Ji-Xuan-Huang/Open-Source-MIDI-Platform/04.KNOBs/Main.pdf

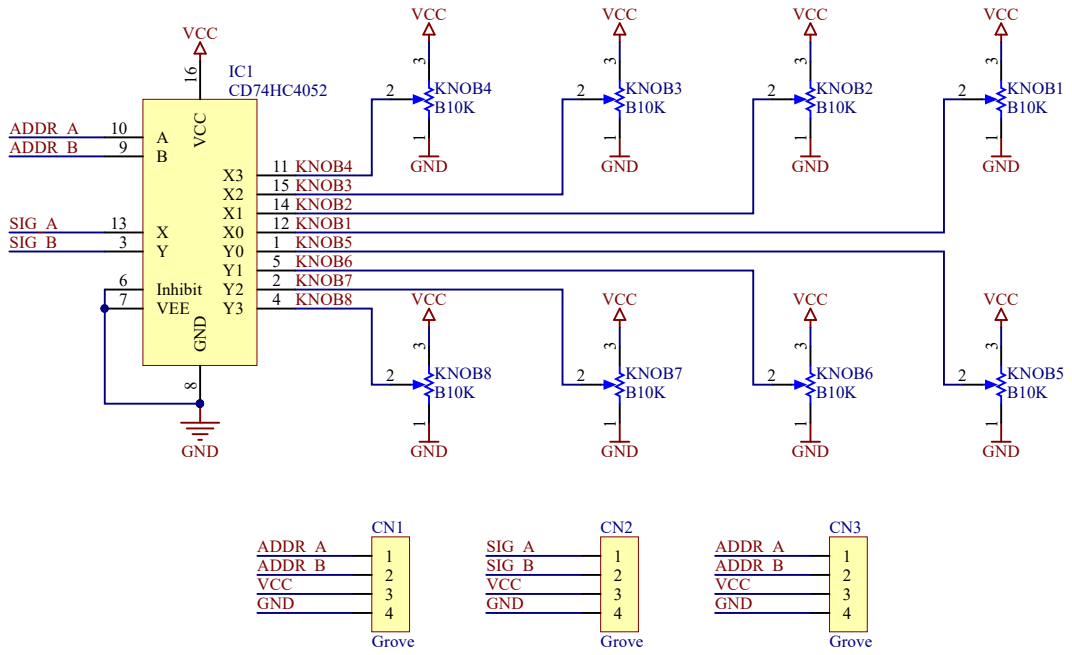
[picture p36: page 1]

5 | KN OB6
2 | KN OB7
