Ji-Xuan-Huang/Open-Source-MIDI-Platform/03.PADs/Main.pdf

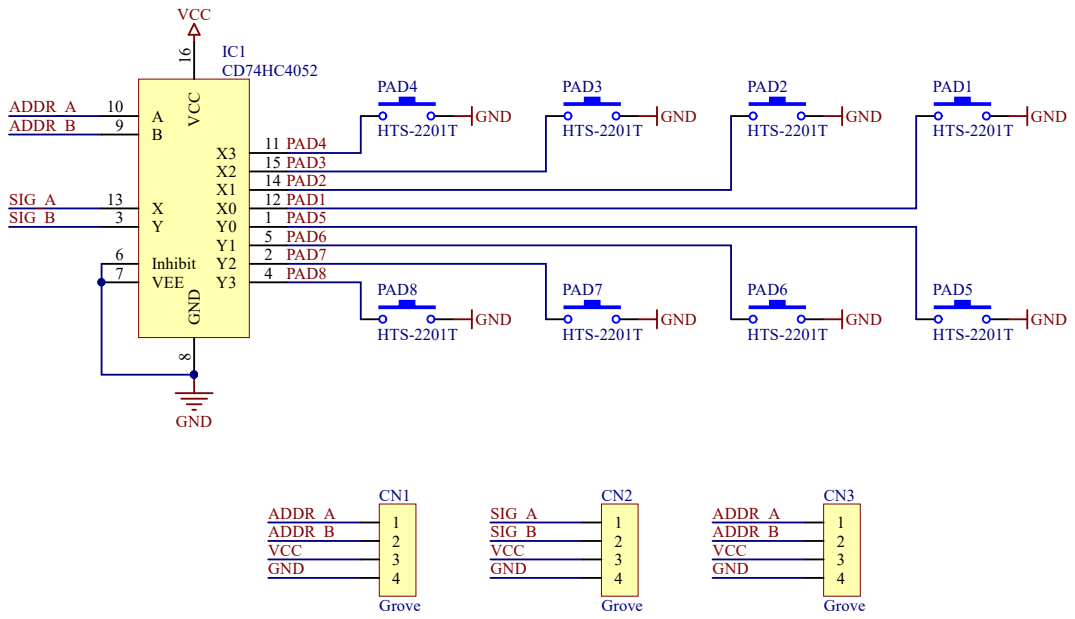
[picture p37: page 1]
