Ji-Xuan-Huang/Open-Source-MIDI-Platform/02.KEYs/Main.pdf

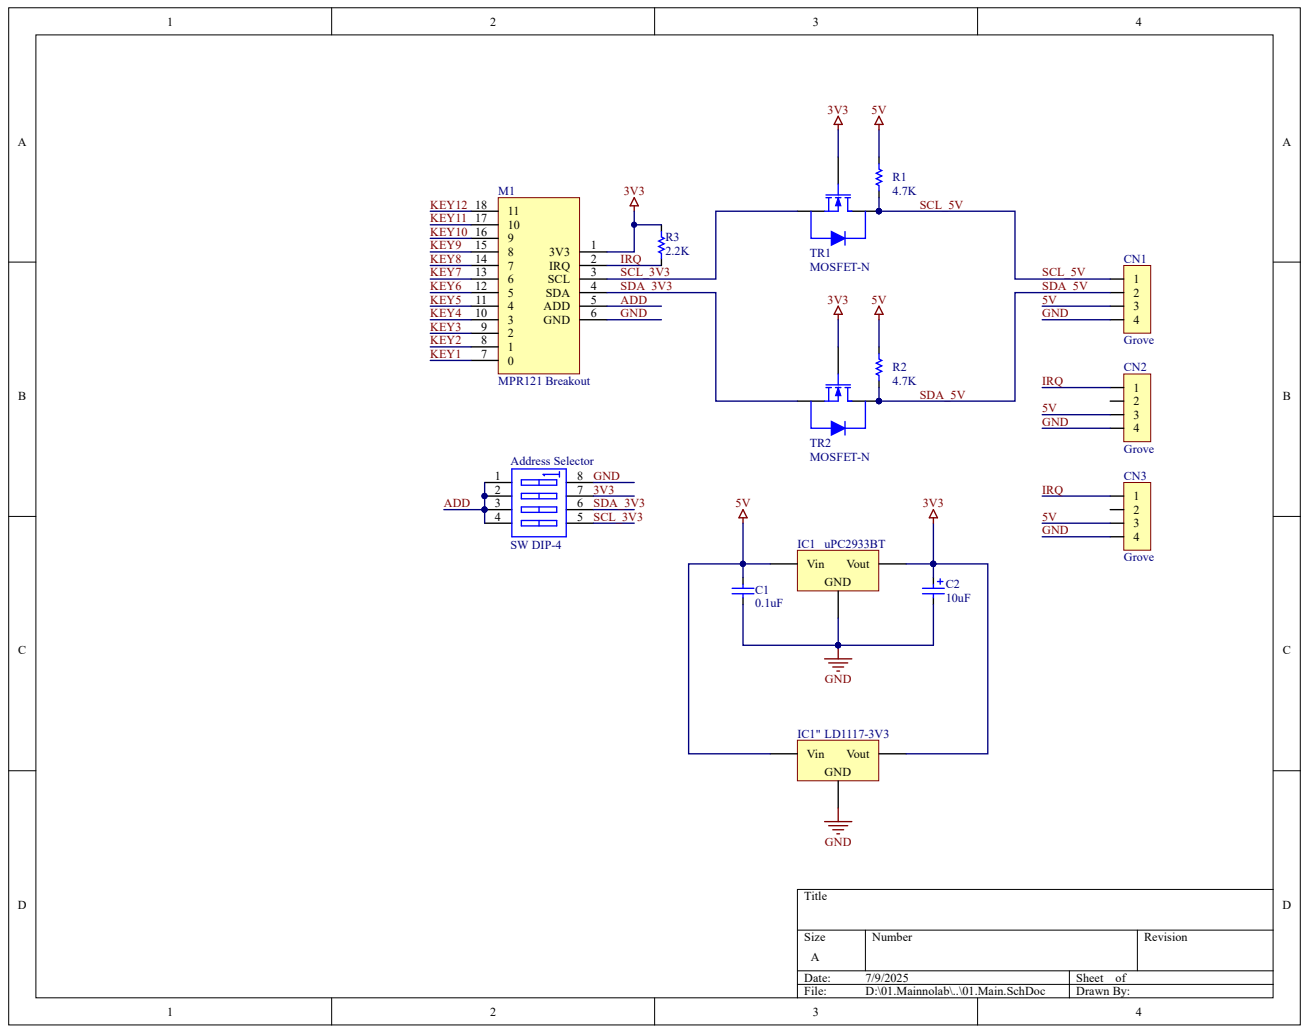
[picture p38: page 1]
