Ji-Xuan-Huang/Open-Source-MIDI-Platform/01.MainBoard/Main.pdf

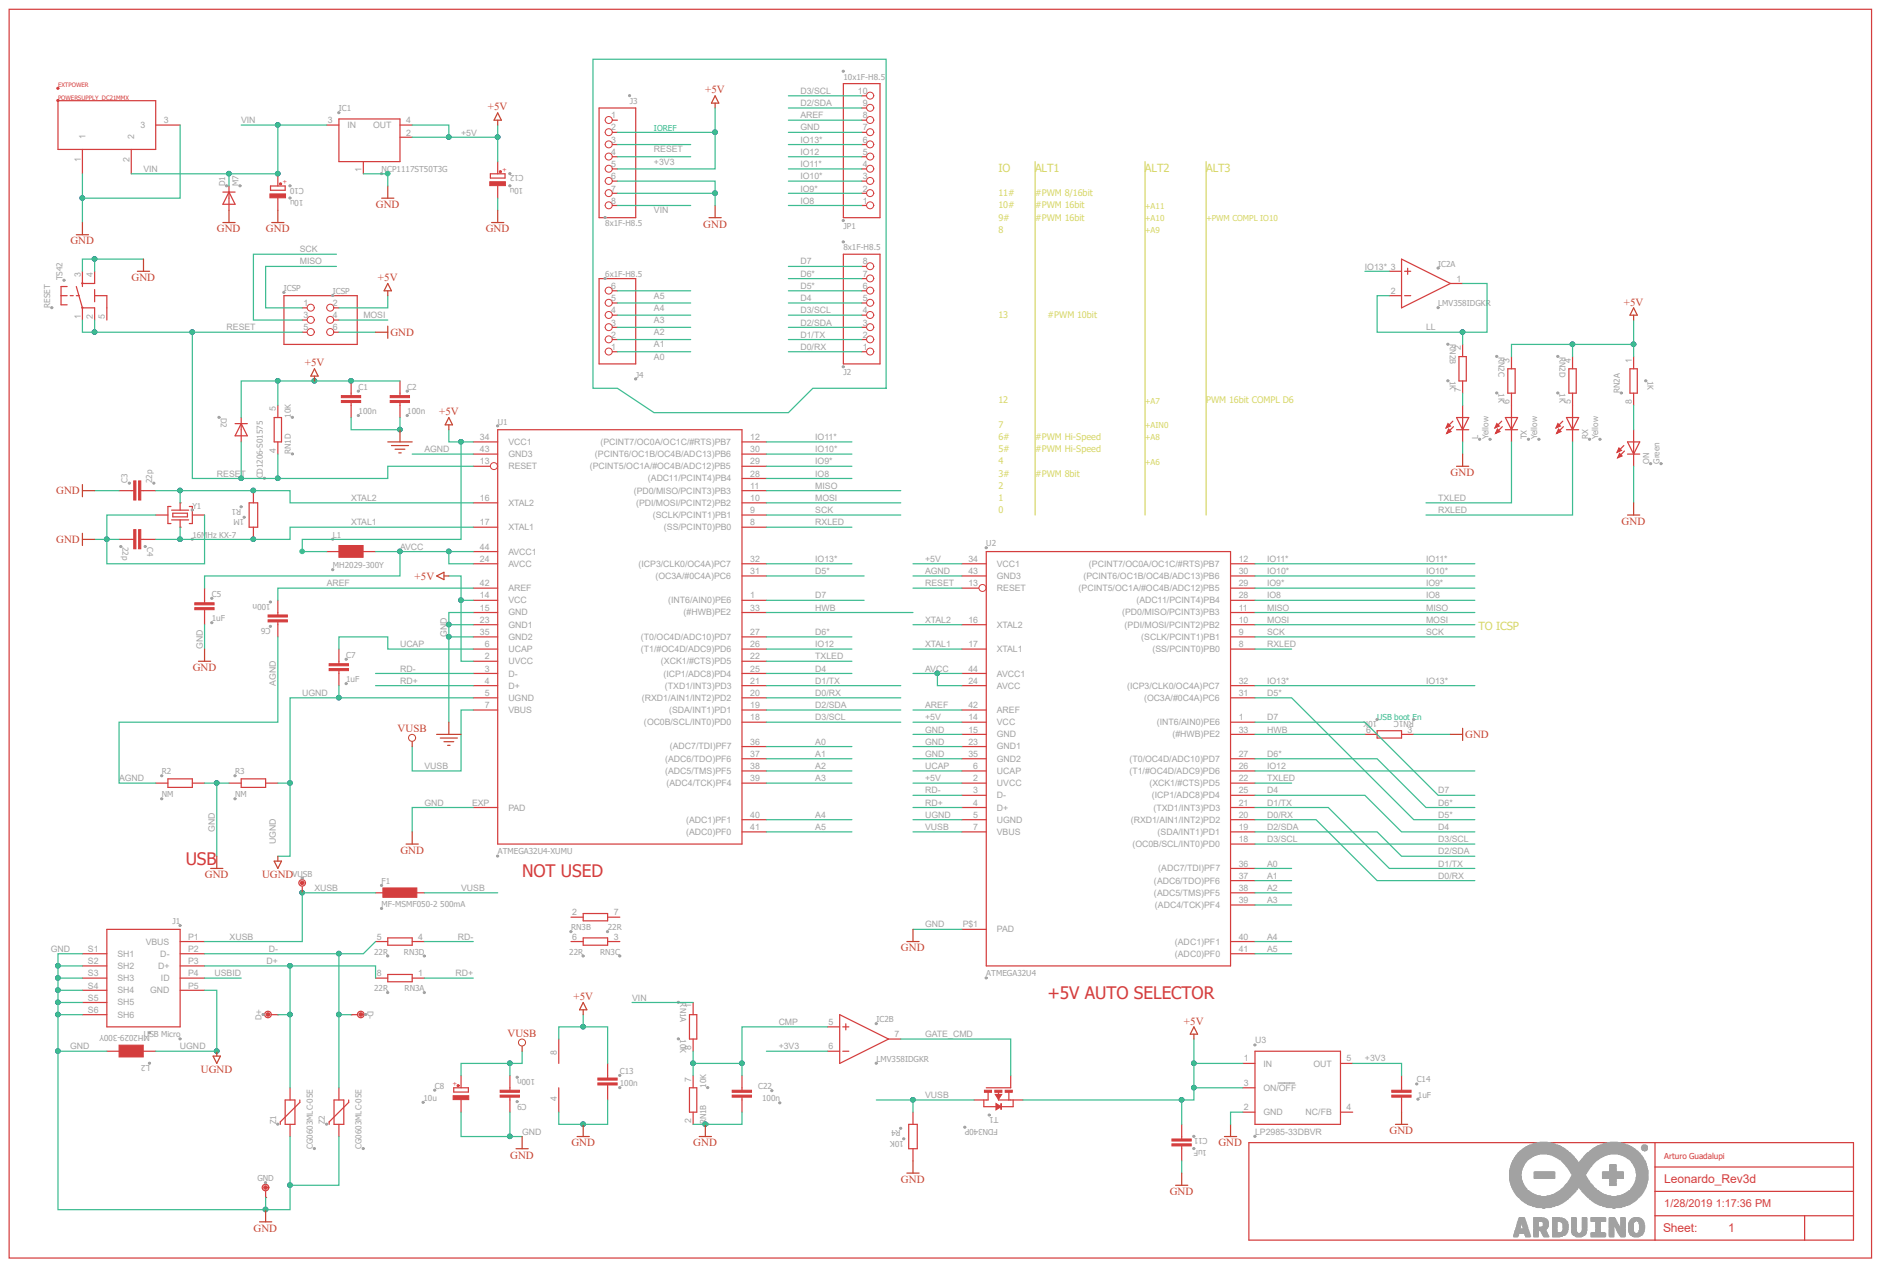
[picture p39: page 1]

AVCC

S 2 | | P D+
S 3 | | P4 5 ID US BID
S 4 | | P

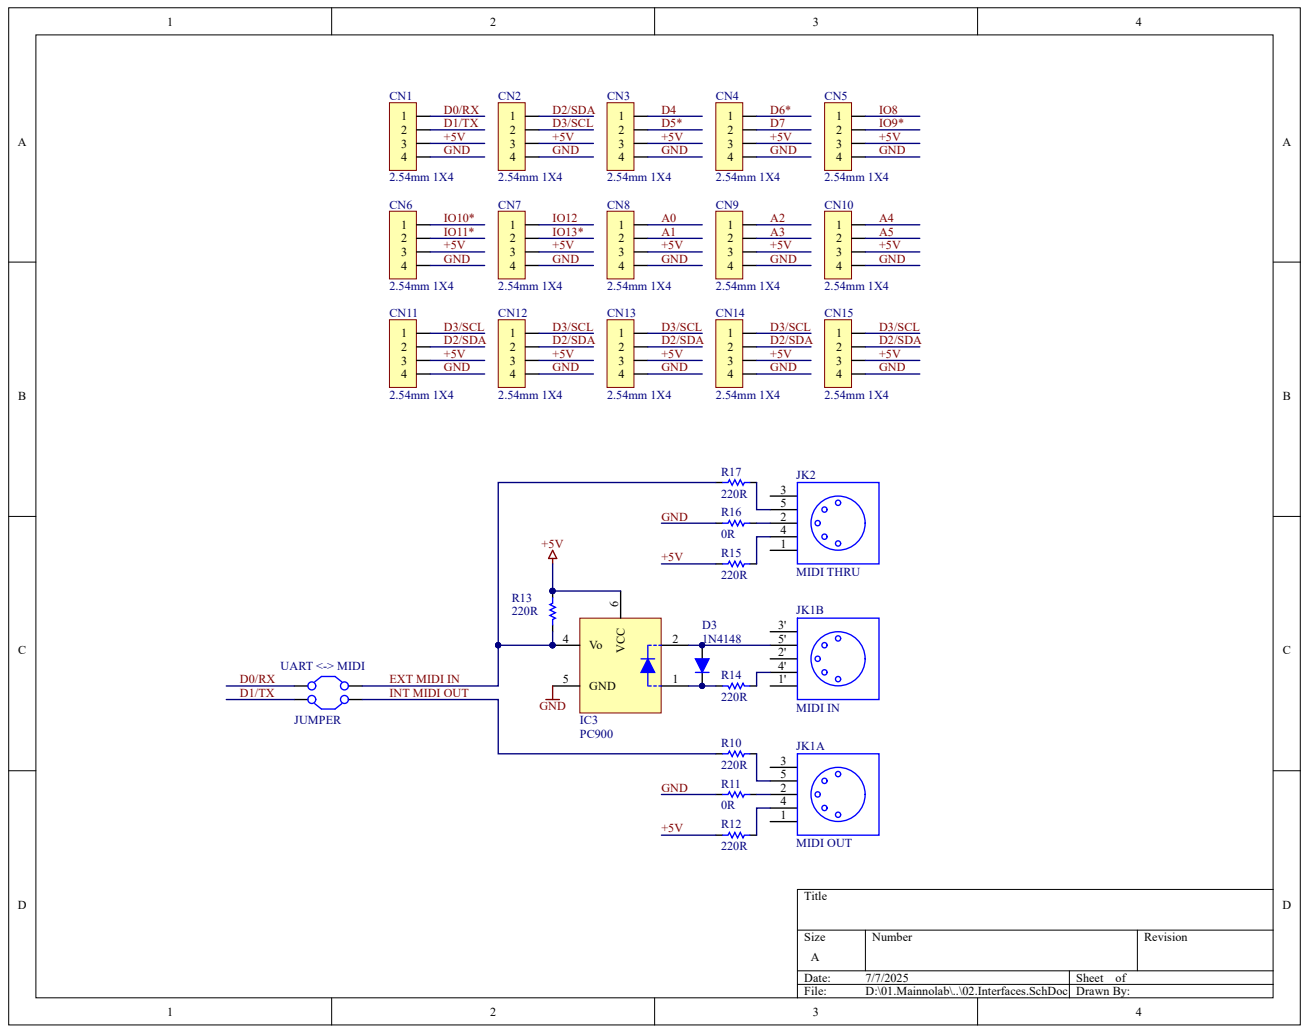
[picture p40: page 2]

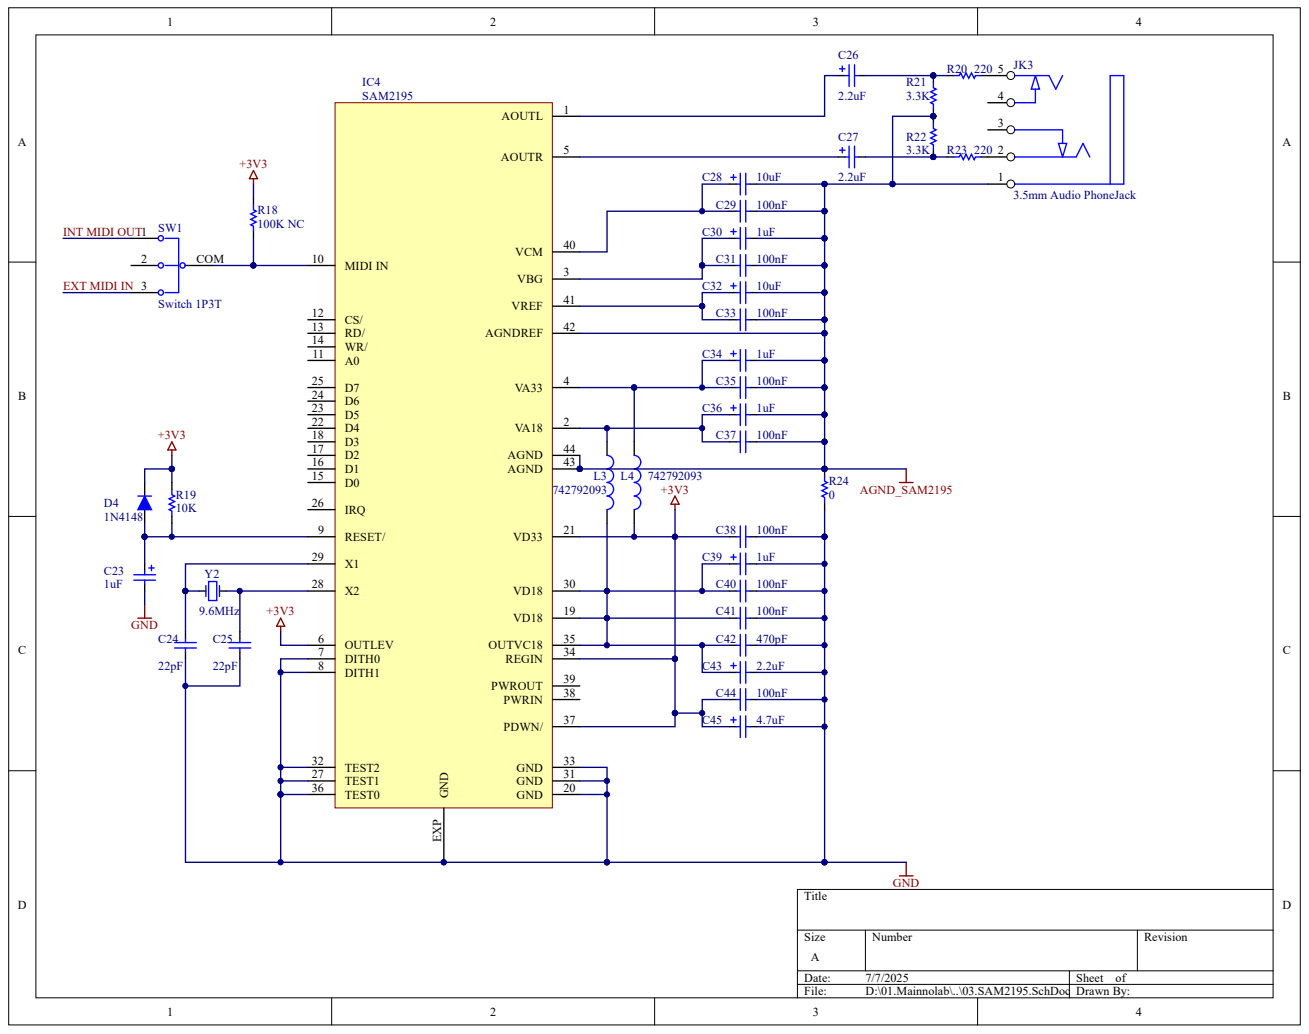
[picture p41: page 3]

TEST2 32

TEST0 36
