Ji-Xuan-Huang/Open-Source-MIDI-Platform/(list of files, drawings)

Other design files:
01.MainBoard/00.main.PcbDoc
01.MainBoard/01.Leonardo_Rev3d.SchDoc
01.MainBoard/02.Interfaces.SchDoc
01.MainBoard/03.SAM2195.SchDoc
01.MainBoard/Leonardo_Rev3d.PcbLib
01.MainBoard/Leonardo_Rev3d.SCHLIB
01.MainBoard/Main.PrjPcb
02.KEYs/00.Main.PcbDoc
02.KEYs/01.Main.SchDoc
02.KEYs/Main.PrjPcb
03.PADs/00.Main.PcbDoc
03.PADs/01.Main.SchDoc
03.PADs/Main.PrjPcb
04.KNOBs/00.Main.PcbDoc
04.KNOBs/01.Main.SchDoc
04.KNOBs/Main.PrjPcb
